Blackbat-AI/ArmBoard_Hardware/README.md

# ArmBoardHardware
Hardware design files for robotic arm

Master branch holds completed versions, branch arm board holds works in progress

Requires KiCAD libraries 5.1.7 and MRDT_KiCAD_Libraries 2021 Release 1
