Blackbat-AI/ArmBoard_Hardware/Documentation/Notes/TivaPinOut.PNG

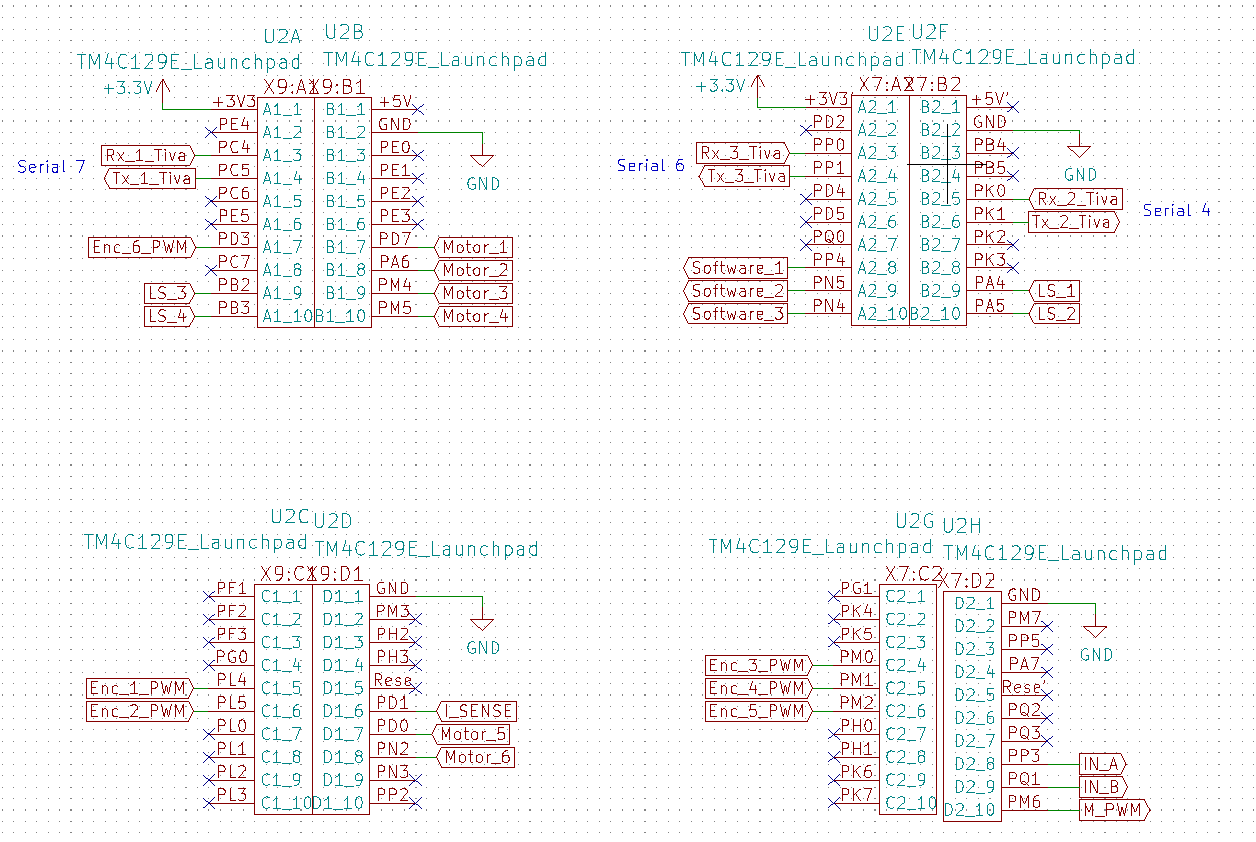
Documentation/Notes/TivaPinOut.PNG
