Blackbat-AI/ArmBoard_Hardware/Manufacturing/Armboard BOM.xlsx

Id | Designator | Package | Designation | Item Name | Part Number | Vendor | Quantity | Cost Per Item | Cost | URL | Comments | Quantity
 | U2 | TM4C129E_Launchpad_FULL_SMD_BOTTOM | TM4C129E_Launchpad | LAUNCHPAD TM4C129E EVAL BRD | 296-44249-ND | Digikey | 1 | $29.99 | $29.99 | EK-TM4C129EXL Texas Instruments | Development Boards, Kits, Programmers | DigiKey (https://www.digikey.com/en/products/detail/texas-instruments/EK-TM4C129EXL/5764631)
 | 47uF2,47uF1 | CP_Radial_D5.0mm_P2.50mm | CP2 | CAP ALUM 47UF 20% 16V RADIAL | 493-15997-ND | Digikey | 1 | $0.26 | $0.26 | USR1C470MDD Nichicon | Capacitors | DigiKey (https://www.digikey.com/en/products/detail/nichicon/USR1C470MDD/2539212)
 | U1 | OKI_Horizontal | OKI | DC DC CONVERTER 3.3V 5W | 811-3014-ND | Digikey | 1 | $4.30 | $4.30 | https://www.digikey.com/product-detail/en/murata-power-solutions-inc/OKI-78SR-3.3-1.5-W36H-C/811-3014-ND/4878851
 | C3,C2,10uF1,10uF2,10uF3,10uF4 | C_0603_1608Metric_Pad1.05x0.95mm_HandSolder | 10uF | CAP CER 10UF 10V X5R 0603 | 399-C0603C106M8PAC7411CT-ND | Digikey | 6 | $0.46 | $2.76 | C0603C106M8PAC7411 KEMET | Capacitors | DigiKey (https://www.digikey.com/en/products/detail/kemet/C0603C106M8PAC7411/12701345)
 | Conn20,Conn19,Conn18,Conn13,Conn12,Conn11,Conn10,Conn9,Conn8 | MOLEX_SL_03_Vertical | Molex_SL_03 | CONN HOUSING 3POS .100 W/LATCH | WM2901-ND | Digikey | 9 | set of 10 for $1.86 | $1.86 | https://www.digikey.com/products/en?keywords=WM2901-ND
 | Conn17,Conn16,Conn15,Conn14 | MOLEX_SL_02_Vertical | Molex_SL_02 | CONN HOUSING 2POS .100 W/LATCH | WM2900-ND | Digikey | 4 | $0.29 | $1.16 | https://www.digikey.com/products/en?keywords=WM2900-ND
 | SW6,SW5,SW4,SW3,SW2,SW1 | SW_Push_1P1T_NO_6x6mm_H9.5mm | SW_Push | SWITCH TACTILE SPST-NO 0.05A 24V | 450-2058-1-ND | Digikey | 6 | $0.37 | $2.22 | FSM6JSMATR TE Connectivity ALCOSWITCH Switches | Switches | DigiKey (https://www.digikey.com/en/products/detail/te-connectivity-alcoswitch-switches/FSM6JSMATR/2400236)
 | R39,R38,R37,R36,R35,R34,R33,R32,R31,R30,R29,R28,R27,R26,R25,R24,R23,R22,R21,R20,R19,R18,R17,R16,R15,R10 | R_0603_1608Metric_Pad1.05x0.95mm_HandSolder | 330 | RES SMD 330 OHM 5% 1/4W 0603 | RHM330DCT-ND | Digikey | 26 | 3 sets of 10 for $0.74 each | $2.22 | ESR03EZPJ331 Rohm Semiconductor | Resistors | DigiKey (https://www.digikey.com/en/products/detail/rohm-semiconductor/ESR03EZPJ331/1762730)
 | R14,R13,R12,R11,R9 | R_0603_1608Metric_Pad1.05x0.95mm_HandSolder | 1.2k | RES SMD 1.2K OHM 5% 1/4W 0603 | RHM1.2KDCT-ND | Digikey | 5 | $0.10 | $0.50 | ESR03EZPJ122 Rohm Semiconductor | Resistors | DigiKey (https://www.digikey.com/en/products/detail/rohm-semiconductor/ESR03EZPJ122/4051189)
 | R8,R7,R6,R4,R2,R1 | R_0603_1608Metric_Pad1.05x0.95mm_HandSolder | 1k | RES SMD 1K OHM 5% 1/4W 0603 | RHM1.0KDCT-ND | Digikey | 6 | $0.10 | $0.60 | https://www.digikey.com/product-detail/en/rohm-semiconductor/ESR03EZPJ102/RHM1.0KDCT-ND/1762924
 | R5 | R_0603_1608Metric_Pad1.05x0.95mm_HandSolder | 10k | RES SMD 10K OHM 1% 1/4W 0603 | RHM10KADCT-ND | Digikey | 1 | $0.12 | $0.12 | https://www.digikey.com/product-detail/en/rohm-semiconductor/ESR03EZPF1002/RHM10KADCT-ND/1983753
 | R3 | R_0603_1608Metric_Pad1.05x0.95mm_HandSolder | 0 | RES SMD 0 OHM JUMPER 1/10W 0603 | 311-0.0GRCT-ND | Digikey | 1 | $0.10 | $0.10 | https://www.digikey.com/products/en?keywords=311-0.0GRCT-ND
 | Gripper_Motor1 | MultiPowerSO_30 | VNH5019A_E | IC MTR DRV 5.5-24V MULTIPWRSO-30 | 497-13073-1-ND | Digikey | 1 | $7.68 | $7.68 | VNH5019A-E STMicroelectronics | Integrated Circuits (ICs) | DigiKey (https://www.digikey.com/en/products/detail/stmicroelectronics/VNH5019A-E/3087979)
 | D6,D3,D4,D5,D2,D7 | LED_0603_1608Metric_Pad1.05x0.95mm_HandSolder | LED | LED GREEN CLEAR SMD | 160-1446-1-ND | Digikey | 6 | $0.26 | $1.56 | https://www.digikey.com/product-detail/en/lite-on-inc/LTST-C191KGKT/160-1446-1-ND/386834
 | D9,D10,D11,D12,D13,D14,D18,D19,D20,D21,D22,D23,D24,D25,D26,D27 | LED_0603_1608Metric_Pad1.05x0.95mm_HandSolder | LED | LED YELLOW CLEAR SMD | 160-1448-1-ND | Digikey | 16 | 2 sets of 10 for $1.51 each | $3.02 | https://www.digikey.com/product-detail/en/lite-on-inc/LTST-C191KSKT/160-1448-1-ND/386838
 | D15,D16,D17,D28,D29,D30,D31,D32,D33 | LED_0603_1608Metric_Pad1.05x0.95mm_HandSolder | LED | LED BLUE CLEAR CHIP SMD | 160-1647-1-ND | Digikey | 9 | set of 10 for $2.62 | $2.62 | https://www.digikey.com/product-detail/en/lite-on-inc/LTST-C191TBKT/160-1647-1-ND/573587
 | D1 | D_SOD-323_HandSoldering | D_Zener | DIODE ZENER 12V 200MW SOD323 | BZX384C12-HE3-08GICT-ND | Digikey | 1 | $0.25 | $0.25 | BZX384C12-HE3-08 Vishay Semiconductor Diodes Division | Discrete Semiconductor Products | DigiKey (https://www.digikey.com/en/products/detail/vishay-semiconductor-diodes-division/BZX384C12-HE3-08/4831089)
 | C1 | C_0603_1608Metric_Pad1.05x0.95mm_HandSolder | 33nF | CAP CER 0.033UF 16V X7R 0603 | 399-C0603C333K4RACAUTOCT-ND | Digikey | 1 | $0.12 | $0.12 | C0603C333K4RACAUTO KEMET | Capacitors | DigiKey (https://www.digikey.com/en/products/detail/kemet/C0603C333K4RACAUTO/11675839)
 | .1uF1 | C_0603_1608Metric_Pad1.05x0.95mm_HandSolder | C1 | CAP CER 0.1UF 16V X7R 0603 | 1276-1005-1-ND | Digikey | 1 | $0.10 | $0.10 | https://www.digikey.com/product-detail/en/samsung-electro-mechanics/CL10B104KO8NNNC/1276-1005-1-ND/3889091
 | Conn1,Conn4,Conn3,Conn2,Conn6 | Anderson_2_Vertical_Sidy_by_Side,Anderson_3_Ho Anderson PP | AndersonPP | Black Anderson Housing | 1327G6 | Powerwerx | 4 | $0.37 | $1.48 | Anderson Power Products 1327 series PP15/30/45 Powerpole Connector Colored Housings | Powerwerx (https://powerwerx.com/anderson-powerpole-colored-housings)
 |  |  |  | Red Anderson Housing | 1327 | Powerwerx | 7 | $0.37 | $2.59 | Anderson Power Products 1327 series PP15/30/45 Powerpole Connector Colored Housings | Powerwerx (https://powerwerx.com/anderson-powerpole-colored-housings)
 |  |  |  | 15A Contact | 1332 | Powerwerx | 11 | $0.18 | $1.98 | 1332-BK Anderson Power PP15 Powerpole Connector Contact, 16-20 GA, 15A, Loose Piece | Powerwerx (https://powerwerx.com/anderson-1332-powerpole-contact-pp15)
 |  |  |  | Vertical Mount | 1335G1 | Powerwerx | 8 | $0.59 | $4.72 | Anderson Power 1335G1 Printed Circuit Board High Power 45 Amp Vertical Contact | Powerwerx (https://powerwerx.com/anderson-1335g1-printed-circuit-board-vertical)
 |  |  |  | Horizontal Mount | 1336G1 | Powerwerx | 3 | $0.55 | $1.65 | Anderson Power 1336G1 Printed Circuit Board High Power 45 Amp Horizontal Bottom Contact | Powerwerx (https://powerwerx.com/anderson-1336g1-printed-circuit-board-horizontal)
