Blackbat-AI/ArmBoard_Hardware/Hardware/Armboard/Armboard.kicad_pcb

## KiCad design Hardware/Armboard/Armboard.kicad_pcb (2020-11-26)

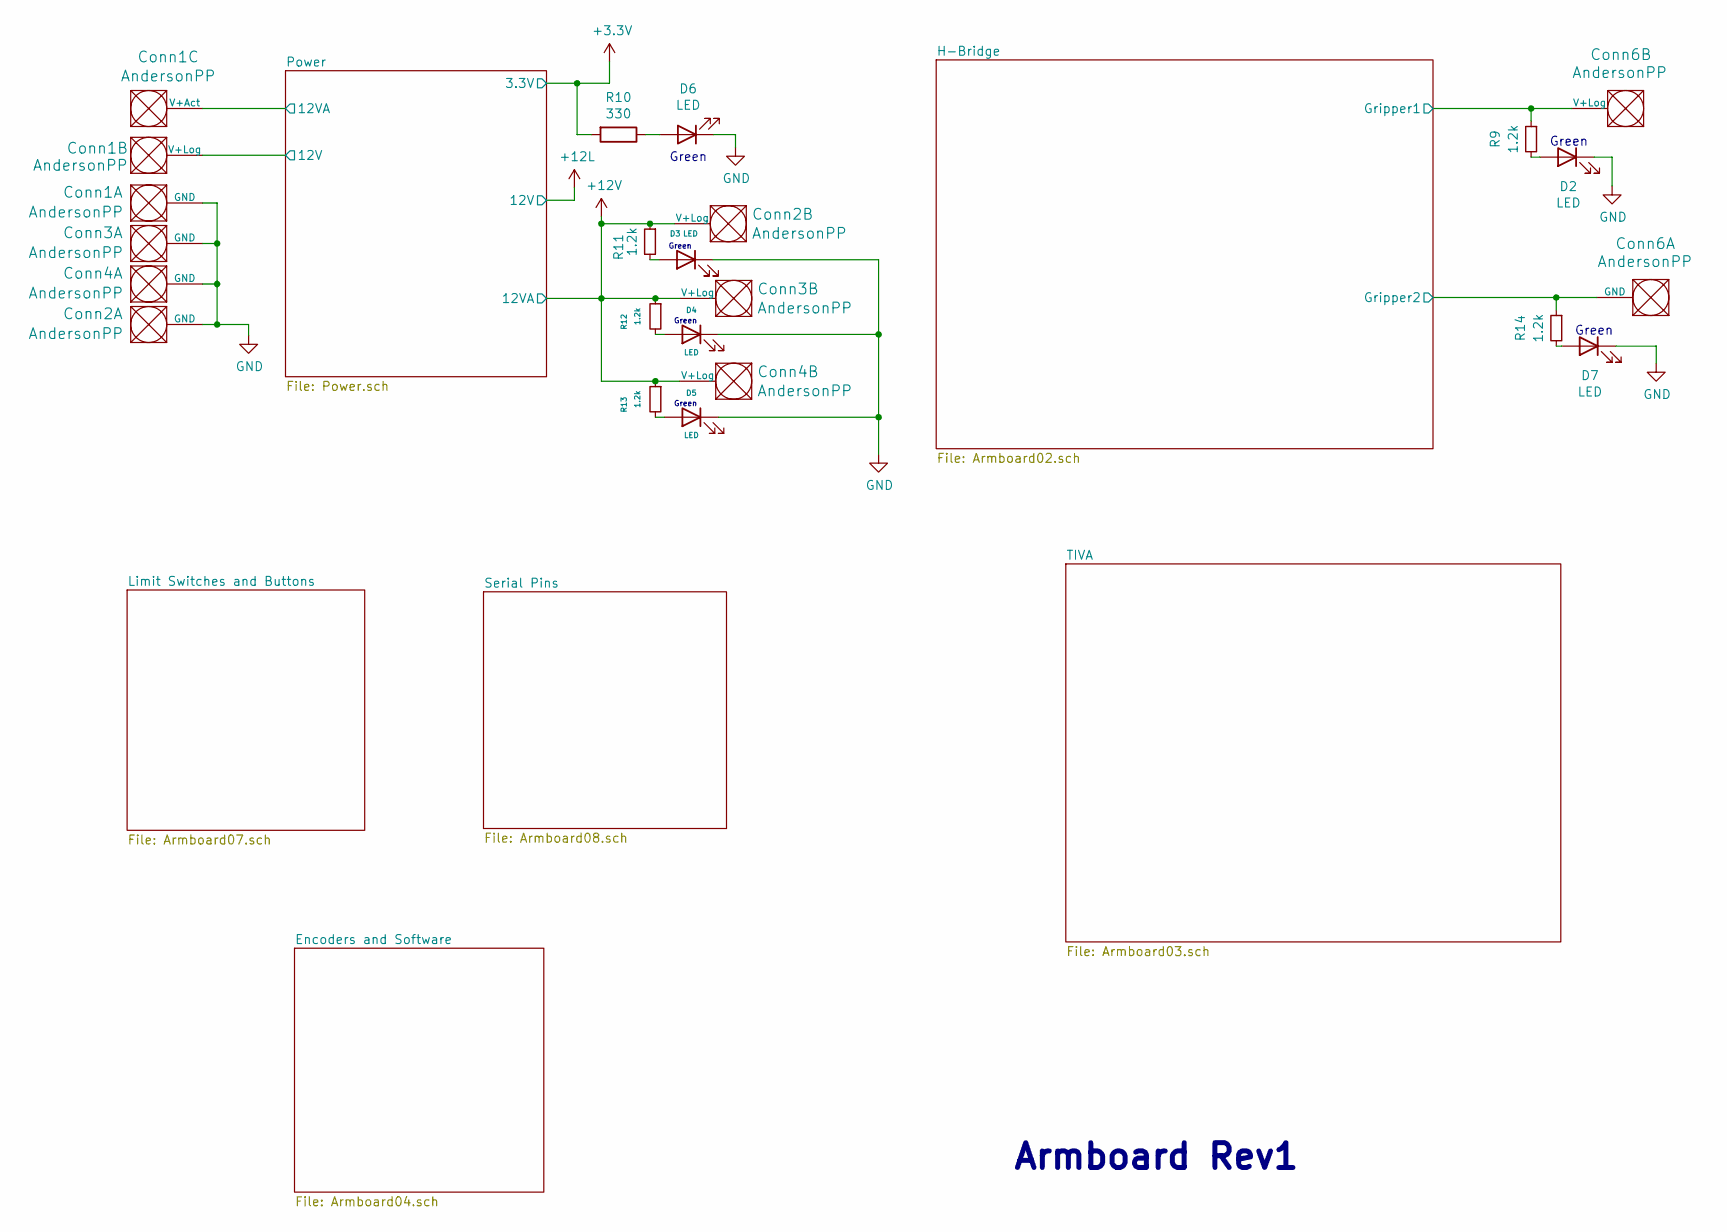
[picture p2: schematic Armboard.sch]

Parts:
Conn1: AndersonPP; Anderson_3_Horizontal_Side_by_Side
Conn2, Conn3, Conn4, Conn6: AndersonPP; Anderson_2_Vertical_Sidy_by_Side
D2, D3, D4, D5, D6, D7: LED; D_0603_1608Metric_Pad1.05x0.95mm_HandSolder
R9, R11, R12, R13, R14: 1.2k; R_0603_1608Metric_Pad0.98x0.95mm_HandSolder
R10: 330; R_0603_1608Metric_Pad0.98x0.95mm_HandSolder

Connections:
+3V3: R10.2; also elsewhere on the board
+12L: Conn1.2 (V+Log); also elsewhere on the board
+12V: Conn1.3 (V+Act), Conn2.2 (V+Log), Conn3.2 (V+Log), Conn4.2 (V+Log), R11.1, R12.1, R13.1; also elsewhere on the board
/H-Bridge/Gripper1: Conn6.2 (V+Log), R9.1; also elsewhere on the board
/H-Bridge/Gripper2: Conn6.1 (GND), R14.1; also elsewhere on the board
GND: Conn1.1 (GND), Conn2.1 (GND), Conn3.1 (GND), Conn4.1 (GND), D2.1 (K), D3.1 (K), D4.1 (K), D5.1 (K), D6.1 (K), D7.1 (K); also elsewhere on the board
unnamed: D2.2 (A), R9.2
unnamed: D3.2 (A), R11.2
unnamed: D4.2 (A), R12.2
unnamed: D5.2 (A), R13.2
unnamed: D6.2 (A), R10.1
unnamed: D7.2 (A), R14.2

Notes on the sheet:
Armboard Rev1
Green

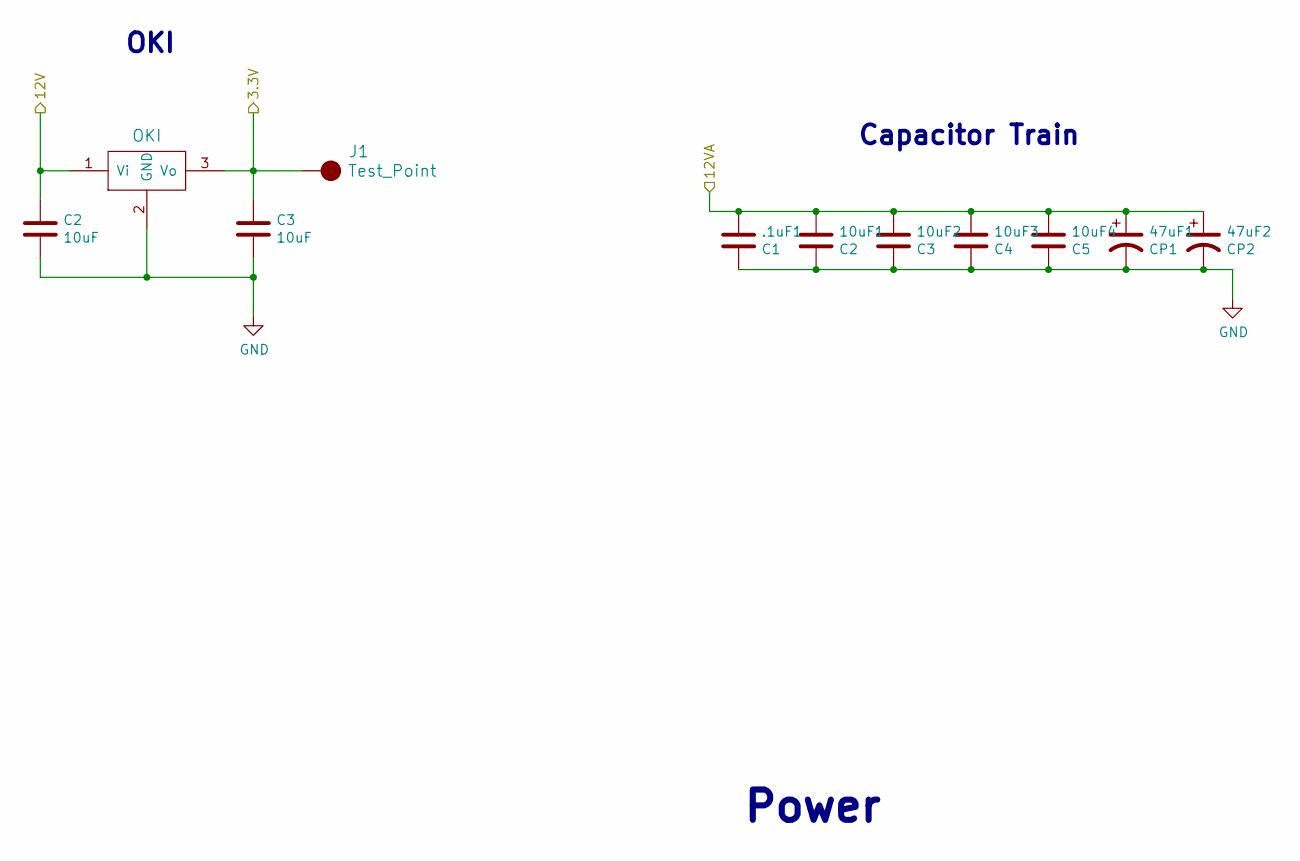
[picture p3: schematic Power.sch]

Parts:
10uF1: C2; C_0603_1608Metric_Pad1.08x0.95mm_HandSolder
10uF2: C3; C_0603_1608Metric_Pad1.08x0.95mm_HandSolder
10uF3: C4; C_0603_1608Metric_Pad1.08x0.95mm_HandSolder
10uF4: C5; C_0603_1608Metric_Pad1.08x0.95mm_HandSolder
47uF1: CP1; CP_Radial_D5.0mm_P2.50mm
47uF2: CP2; CP_Radial_D5.0mm_P2.50mm
.1uF1: C1; C_0603_1608Metric_Pad1.08x0.95mm_HandSolder
C2, C3: 10uF; C_0603_1608Metric_Pad1.08x0.95mm_HandSolder
J1: Test_Point; TestPoint_Pad_3.0x3.0mm
U1: OKI; OKI_Horizontal

Connections:
+3V3: C3.1, J1.1, U1.3 (Vo); also elsewhere on the board
+12L: C2.1, U1.1 (Vi); also elsewhere on the board
+12V: 10uF1.1, 10uF2.1, 10uF3.1, 10uF4.1, 47uF1.1, 47uF2.1, .1uF1.1; also elsewhere on the board
GND: 10uF1.2, 10uF2.2, 10uF3.2, 10uF4.2, 47uF1.2, 47uF2.2, .1uF1.2, C2.2, C3.2, U1.2 (GND); also elsewhere on the board

Notes on the sheet:
Capacitor Train
Power
OKI

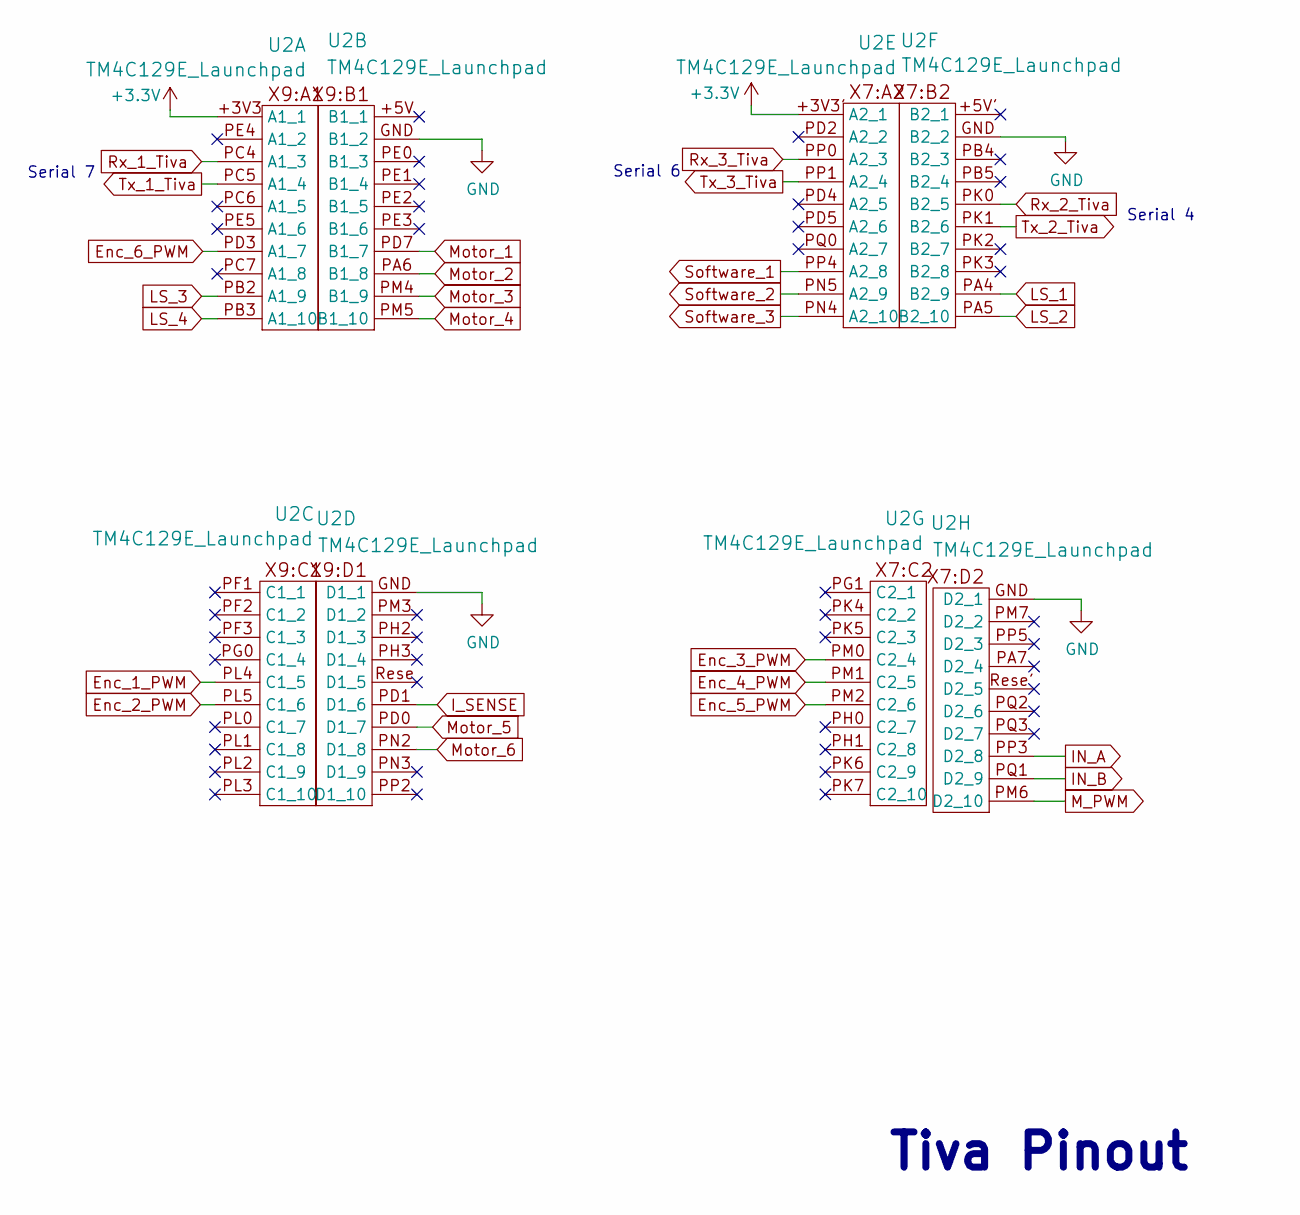
[picture p4: schematic Armboard03.sch]

Parts:
U2: TM4C129E_Launchpad; TM4C129E_Launchpad_FULL_SMD_BOTTOM

Connections:
+3V3: U2.+3V3 (A1_1), U2.+3V3' (A2_1); also elsewhere on the board
Enc_1_PWM: U2.PL4 (C1_5); also elsewhere on the board
Enc_2_PWM: U2.PL5 (C1_6); also elsewhere on the board
Enc_3_PWM: U2.PM0 (C2_4); also elsewhere on the board
Enc_4_PWM: U2.PM1 (C2_5); also elsewhere on the board
Enc_5_PWM: U2.PM2 (C2_6); also elsewhere on the board
Enc_6_PWM: U2.PD3 (A1_7); also elsewhere on the board
GND: U2.GND (B1_2); also elsewhere on the board
IN_A: U2.PP3 (D2_8); also elsewhere on the board
IN_B: U2.PQ1 (D2_9); also elsewhere on the board
I_SENSE: U2.PD1 (D1_6); also elsewhere on the board
LS_1: U2.PA4 (B2_9); also elsewhere on the board
LS_2: U2.PA5 (B2_10); also elsewhere on the board
LS_3: U2.PB2 (A1_9); also elsewhere on the board
LS_4: U2.PB3 (A1_10); also elsewhere on the board
M_PWM: U2.PM6 (D2_10); also elsewhere on the board
Motor_1: U2.PD7 (B1_7); also elsewhere on the board
Motor_2: U2.PA6 (B1_8); also elsewhere on the board
Motor_3: U2.PM4 (B1_9); also elsewhere on the board
Motor_4: U2.PM5 (B1_10); also elsewhere on the board
Motor_5: U2.PD0 (D1_7); also elsewhere on the board
Motor_6: U2.PN2 (D1_8); also elsewhere on the board
Rx_1_Tiva: U2.PC4 (A1_3); also elsewhere on the board
Rx_2_Tiva: U2.PK0 (B2_5); also elsewhere on the board
Rx_3_Tiva: U2.PP0 (A2_3); also elsewhere on the board
Software_1: U2.PP4 (A2_8); also elsewhere on the board
Software_2: U2.PN5 (A2_9); also elsewhere on the board
Software_3: U2.PN4 (A2_10); also elsewhere on the board
Tx_1_Tiva: U2.PC5 (A1_4); also elsewhere on the board
Tx_2_Tiva: U2.PK1 (B2_6); also elsewhere on the board
Tx_3_Tiva: U2.PP1 (A2_4); also elsewhere on the board

Notes on the sheet:
Tiva Pinout
Serial 6
Serial 7
Serial 4

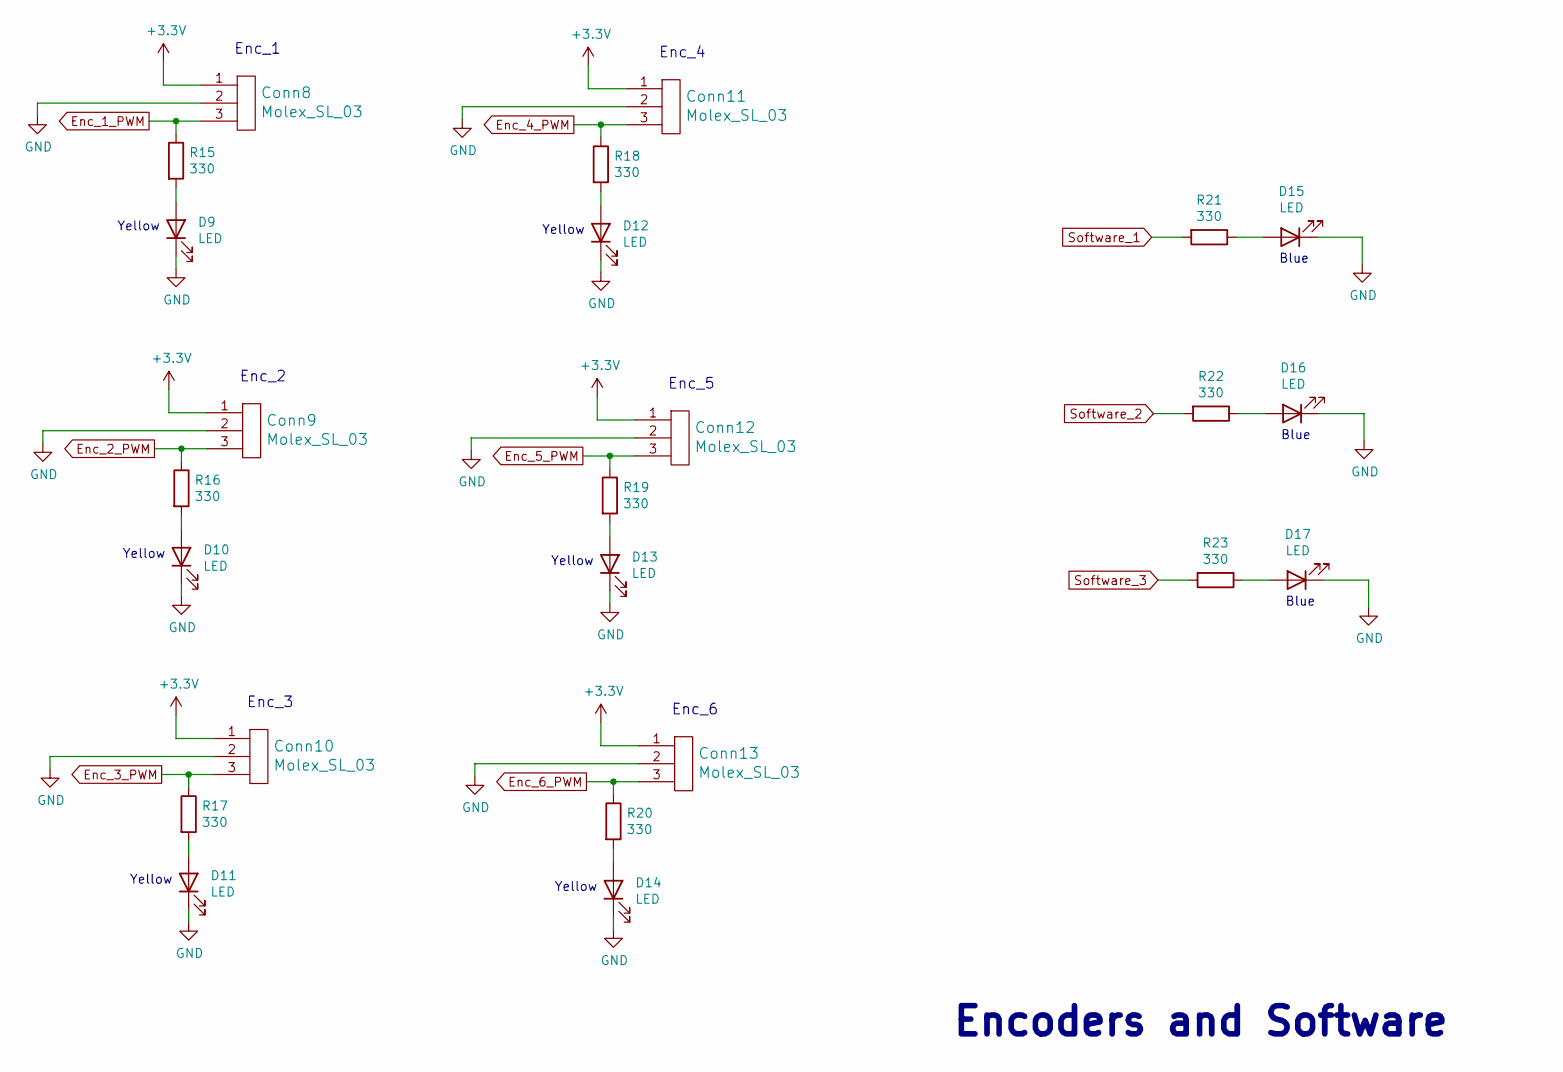
[picture p5: schematic Armboard04.sch]

Parts:
Conn8, Conn9, Conn10, Conn11, Conn12, Conn13: Molex_SL_03; MOLEX_SL_03_Vertical
D9, D10, D11, D12, D13, D14, D15, D16, D17: LED; D_0603_1608Metric_Pad1.05x0.95mm_HandSolder
R15, R16, R17, R18, R19, R20, R21, R22, R23: 330; R_0603_1608Metric_Pad0.98x0.95mm_HandSolder

Connections:
+3V3: Conn8.1, Conn9.1, Conn10.1, Conn11.1, Conn12.1, Conn13.1; also elsewhere on the board
Enc_1_PWM: Conn8.3, R15.1; also elsewhere on the board
Enc_2_PWM: Conn9.3, R16.1; also elsewhere on the board
Enc_3_PWM: Conn10.3, R17.1; also elsewhere on the board
Enc_4_PWM: Conn11.3, R18.1; also elsewhere on the board
Enc_5_PWM: Conn12.3, R19.1; also elsewhere on the board
Enc_6_PWM: Conn13.3, R20.1; also elsewhere on the board
GND: Conn8.2, Conn9.2, Conn10.2, Conn11.2, Conn12.2, Conn13.2, D9.1 (K), D10.1 (K), D11.1 (K), D12.1 (K), D13.1 (K), D14.1 (K), D15.1 (K), D16.1 (K), D17.1 (K); also elsewhere on the board
unnamed: D9.2 (A), R15.2
unnamed: D10.2 (A), R16.2
unnamed: D11.2 (A), R17.2
unnamed: D12.2 (A), R18.2
unnamed: D13.2 (A), R19.2
unnamed: D14.2 (A), R20.2
unnamed: D15.2 (A), R21.1
unnamed: D16.2 (A), R22.1
unnamed: D17.2 (A), R23.1
Software_1: R21.2; also elsewhere on the board
Software_2: R22.2; also elsewhere on the board
Software_3: R23.2; also elsewhere on the board

Notes on the sheet:
Enc_2
Enc_3
Enc_4
Enc_5
Enc_6
Encoders and Software
Enc_1
Yellow
Blue

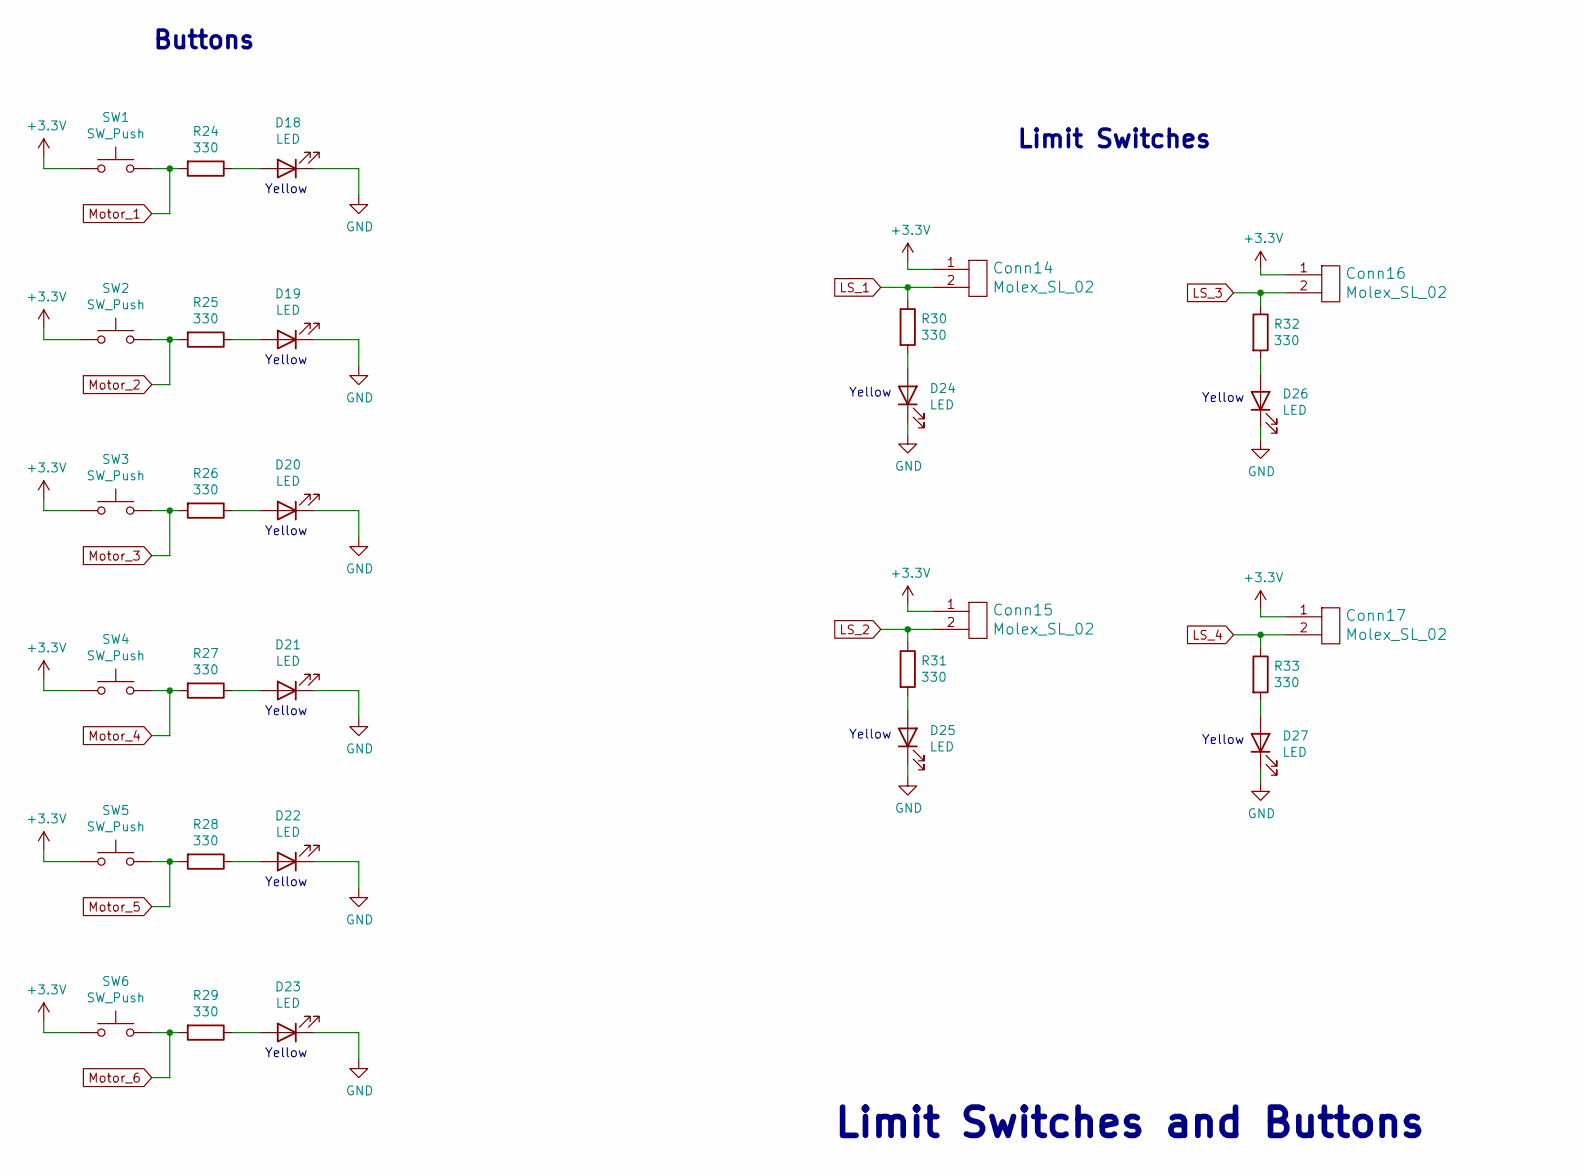
[picture p6: schematic Armboard07.sch]

Parts:
Conn14, Conn15, Conn16, Conn17: Molex_SL_02; MOLEX_SL_02_Vertical
D18, D19, D20, D21, D22, D23, D24, D25, D26, D27: LED; D_0603_1608Metric_Pad1.05x0.95mm_HandSolder
R24, R25, R26, R27, R28, R29, R30, R31, R32, R33: 330; R_0603_1608Metric_Pad0.98x0.95mm_HandSolder
SW1, SW2, SW3, SW4, SW5, SW6: SW_Push; SW_Push_1P1T_NO_6x6mm_H9.5mm

Connections:
+3V3: Conn14.1, Conn15.1, Conn16.1, Conn17.1, SW1.1, SW2.1, SW3.1, SW4.1, SW5.1, SW6.1; also elsewhere on the board
GND: D18.1 (K), D19.1 (K), D20.1 (K), D21.1 (K), D22.1 (K), D23.1 (K), D24.1 (K), D25.1 (K), D26.1 (K), D27.1 (K); also elsewhere on the board
LS_1: Conn14.2, R30.1; also elsewhere on the board
LS_2: Conn15.2, R31.1; also elsewhere on the board
LS_3: Conn16.2, R32.1; also elsewhere on the board
LS_4: Conn17.2, R33.1; also elsewhere on the board
Motor_1: R24.2, SW1.2; also elsewhere on the board
Motor_2: R25.2, SW2.2; also elsewhere on the board
Motor_3: R26.2, SW3.2; also elsewhere on the board
Motor_4: R27.2, SW4.2; also elsewhere on the board
Motor_5: R28.2, SW5.2; also elsewhere on the board
Motor_6: R29.2, SW6.2; also elsewhere on the board
unnamed: D18.2 (A), R24.1
unnamed: D19.2 (A), R25.1
unnamed: D20.2 (A), R26.1
unnamed: D21.2 (A), R27.1
unnamed: D22.2 (A), R28.1
unnamed: D23.2 (A), R29.1
unnamed: D24.2 (A), R30.2
unnamed: D25.2 (A), R31.2
unnamed: D26.2 (A), R32.2
unnamed: D27.2 (A), R33.2

Notes on the sheet:
Yellow
Limit Switches and Buttons
Limit Switches
Buttons

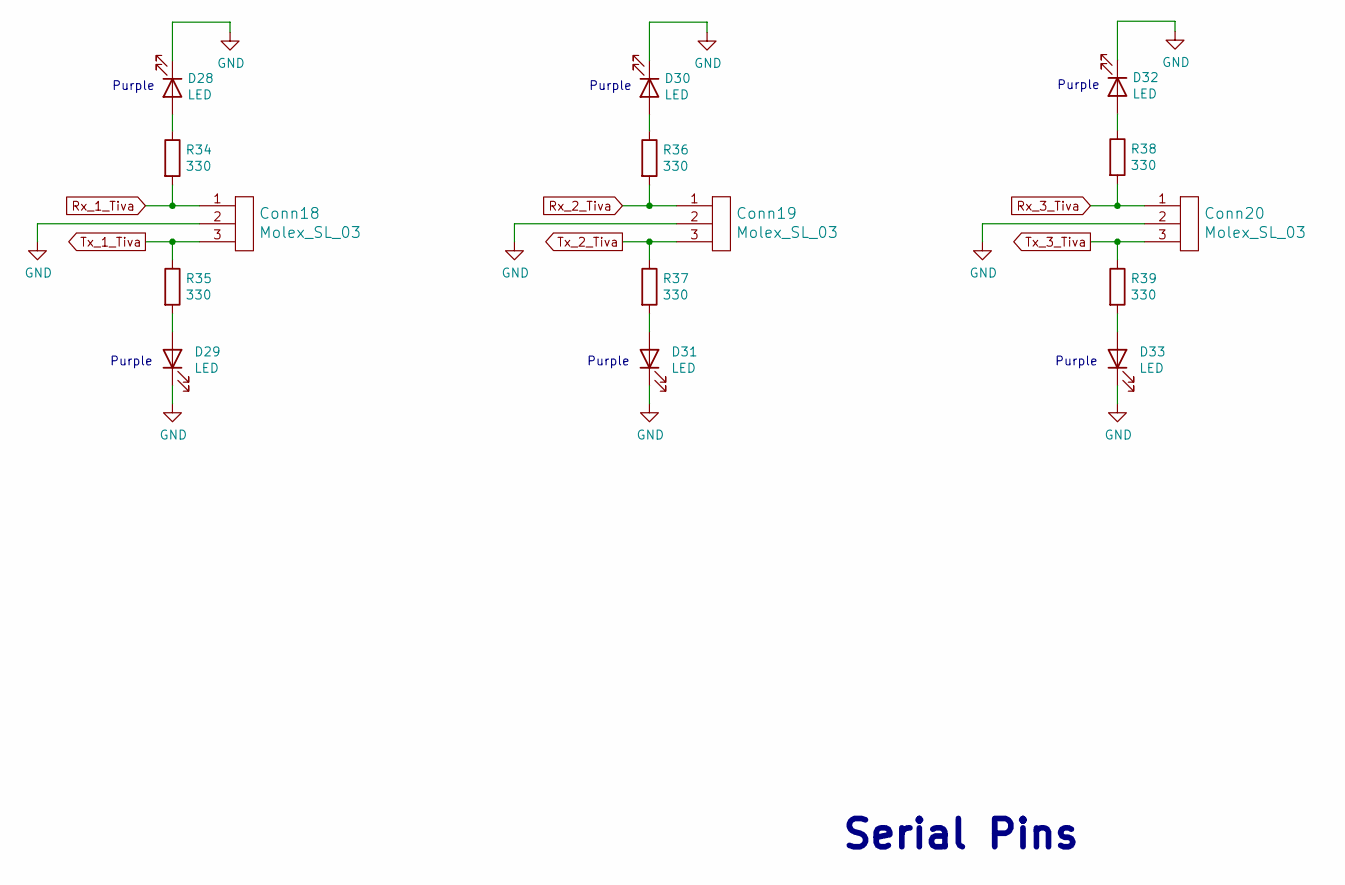
[picture p7: schematic Armboard08.sch]

Parts:
Conn18, Conn19, Conn20: Molex_SL_03; MOLEX_SL_03_Vertical
D28, D29, D30, D31, D32, D33: LED; D_0603_1608Metric_Pad1.05x0.95mm_HandSolder
R34, R35, R36, R37, R38, R39: 330; R_0603_1608Metric_Pad0.98x0.95mm_HandSolder

Connections:
GND: Conn18.2, Conn19.2, Conn20.2, D28.1 (K), D29.1 (K), D30.1 (K), D31.1 (K), D32.1 (K), D33.1 (K); also elsewhere on the board
unnamed: D28.2 (A), R34.1
unnamed: D29.2 (A), R35.2
unnamed: D30.2 (A), R36.1
unnamed: D31.2 (A), R37.2
unnamed: D32.2 (A), R38.1
unnamed: D33.2 (A), R39.2
Rx_1_Tiva: Conn18.1, R34.2; also elsewhere on the board
Rx_2_Tiva: Conn19.1, R36.2; also elsewhere on the board
Rx_3_Tiva: Conn20.1, R38.2; also elsewhere on the board
Tx_1_Tiva: Conn18.3, R35.1; also elsewhere on the board
Tx_2_Tiva: Conn19.3, R37.1; also elsewhere on the board
Tx_3_Tiva: Conn20.3, R39.1; also elsewhere on the board

Notes on the sheet:
Serial Pins
Purple

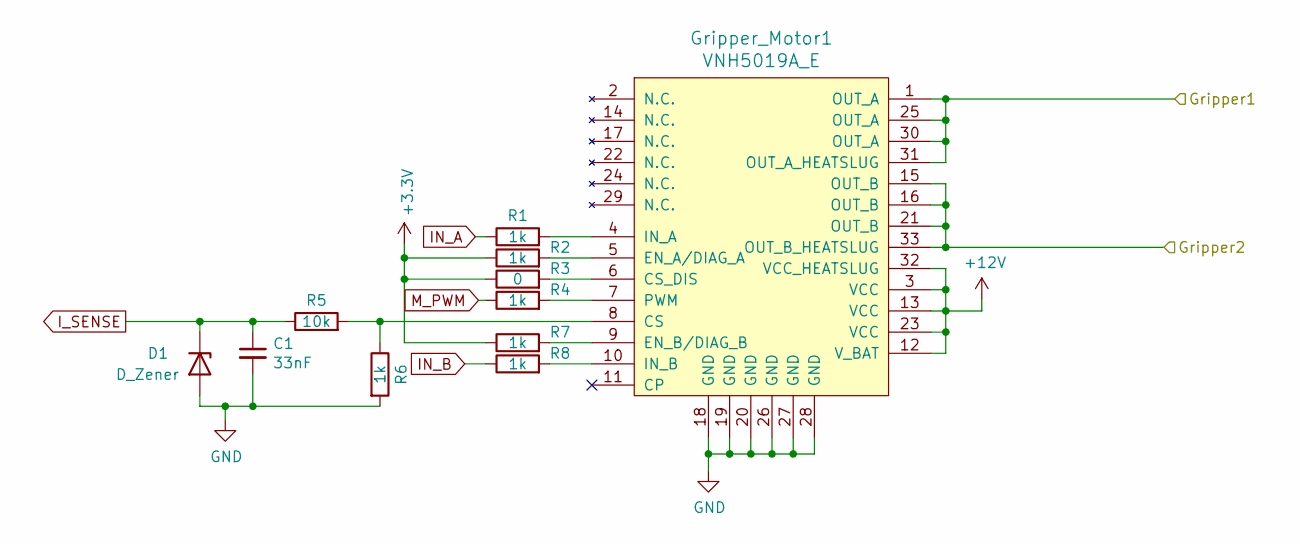
[picture p8: schematic Armboard02.sch]

Parts:
C1: 33nF; C_0603_1608Metric_Pad1.08x0.95mm_HandSolder
D1: D_Zener; D_SOD-323_HandSoldering
Gripper_Motor1: VNH5019A_E; MultiPowerSO_30
R1, R2, R4, R6, R7, R8: 1k; R_0603_1608Metric_Pad0.98x0.95mm_HandSolder
R3: 0; R_0603_1608Metric_Pad0.98x0.95mm_HandSolder
R5: 10k; R_0603_1608Metric_Pad0.98x0.95mm_HandSolder

Connections:
+3V3: R2.1, R3.1, R7.1; also elsewhere on the board
+12V: Gripper_Motor1.3 (VCC), Gripper_Motor1.12 (V_BAT), Gripper_Motor1.13 (VCC), Gripper_Motor1.23 (VCC), Gripper_Motor1.32 (VCC_HEATSLUG); also elsewhere on the board
/H-Bridge/Gripper1: Gripper_Motor1.1 (OUT_A), Gripper_Motor1.25 (OUT_A), Gripper_Motor1.30 (OUT_A), Gripper_Motor1.31 (OUT_A_HEATSLUG); also elsewhere on the board
/H-Bridge/Gripper2: Gripper_Motor1.15 (OUT_B), Gripper_Motor1.16 (OUT_B), Gripper_Motor1.21 (OUT_B), Gripper_Motor1.33 (OUT_B_HEATSLUG); also elsewhere on the board
GND: C1.2, D1.2 (A), Gripper_Motor1.18 (GND), Gripper_Motor1.19 (GND), Gripper_Motor1.20 (GND), Gripper_Motor1.26 (GND), Gripper_Motor1.27 (GND), Gripper_Motor1.28 (GND), R6.2; also elsewhere on the board
IN_A: R1.1; also elsewhere on the board
IN_B: R8.1; also elsewhere on the board
I_SENSE: C1.1, D1.1 (K), R5.1; also elsewhere on the board
M_PWM: R4.1; also elsewhere on the board
unnamed: Gripper_Motor1.4 (IN_A), R1.2
unnamed: Gripper_Motor1.5 (EN_A/DIAG_A), R2.2
unnamed: Gripper_Motor1.6 (CS_DIS), R3.2
unnamed: Gripper_Motor1.7 (PWM), R4.2
unnamed: Gripper_Motor1.8 (CS), R5.2, R6.1
unnamed: Gripper_Motor1.9 (EN_B/DIAG_B), R7.2
unnamed: Gripper_Motor1.10 (IN_B), R8.2

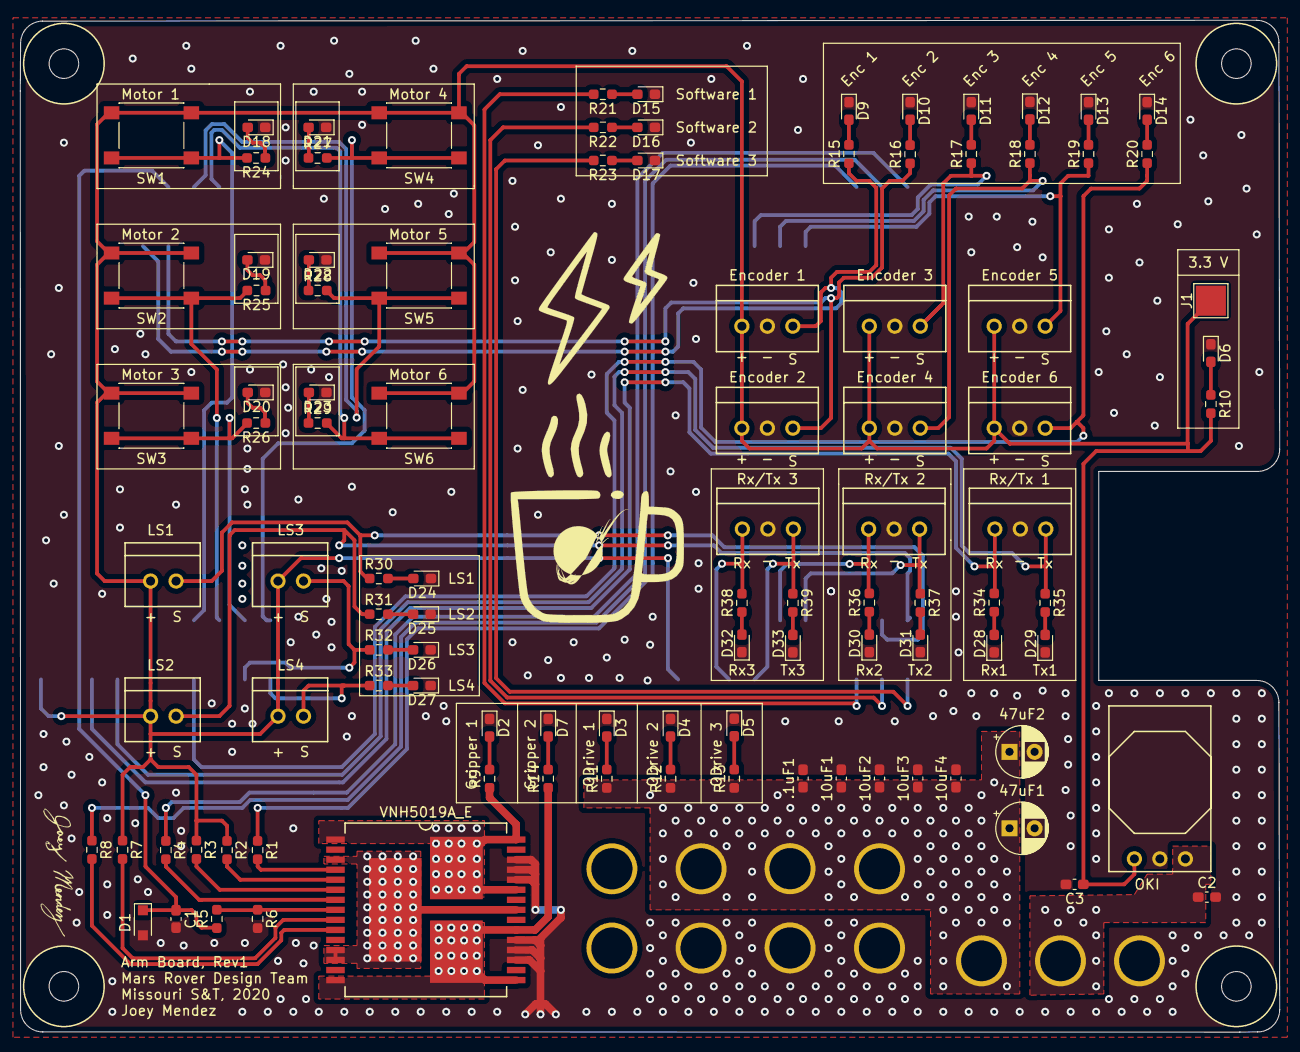
[picture p9: board Armboard.kicad_pcb from above]

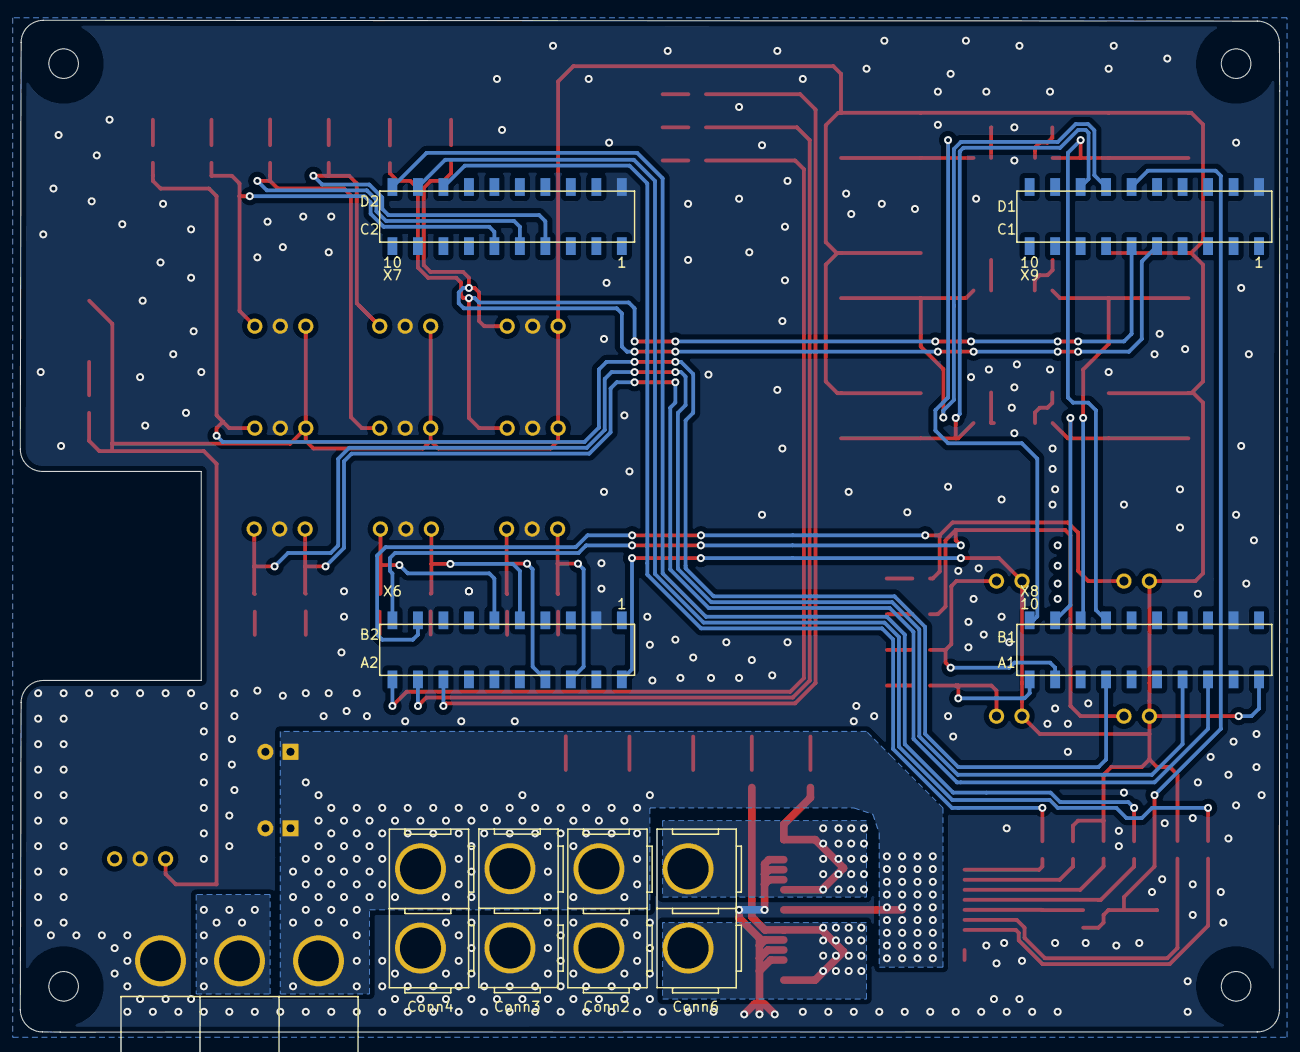
[picture p10: board Armboard.kicad_pcb from below]

Board: 2 copper layers, 125.5 x 100.8 mm, 109 parts (5 on the bottom side), 73 nets.
