Blackbat-AI/ArmBoard_Hardware/(commit log)

2020-09-11 Created Project
    [ArmBoard_Hardware-B_Cu.gbr, ArmBoard_Hardware-B_Mask.gbr, ArmBoard_Hardware-B_Paste.gbr, ArmBoard_Hardware-B_SilkS.gbr, ArmBoard_Hardware-Edge_Cuts.gbr, ArmBoard_Hardware-F_Cu.gbr, ArmBoard_Hardware-F_Mask.gbr, ArmBoard_Hardware-F_Paste.gbr]
2020-09-11 Created proper page size and one hierarchal sheet for indicators
    [Armboard1.sch]
2020-09-20 Added Capacitor Train to Power Heirarchal sheet
    [Armboard.sch, Power.sch]
2020-09-20 Added Anderson connectors to power section
    [Power.sch]
2020-09-20 Power Board Schematic Update
    [Power.sch]
2020-09-20 Added OKI to power
    [Power.sch]
2020-09-29 Put Anderson connectors on front page, replaced OKI with Buckman converter
    [Armboard.sch, Armboard1.sch, Power.sch]
2020-09-29 Added empty heirarchical sheets
    [Armboard.sch, Armboard01.sch, Armboard02.sch, Armboard03.sch, Armboard04.sch, Armboard05.sch, Armboard06.sch, Armboard07.sch]
2020-09-30 Added nothing
    [Armboard.sch, Armboard02.sch, Armboard03.sch, Armboard04.sch, Armboard05.sch, Armboard06.sch, Armboard07.sch, Armboard08.sch]
2020-09-30 Added TIVA Device and changed page sizes
    [Armboard02.sch, Armboard03.sch, Armboard04.sch, Armboard05.sch, Armboard06.sch, Armboard07.sch, Armboard08.sch, Power.sch]
2020-10-03 Added, Solenoid actuation, laser control, and encoders
    [Armboard04.sch, Armboard05.sch, Armboard06.sch]
2020-10-08 H-Bridge completed
    Completed the H-Bridge Hierarchal Sheet
    [Armboard.sch, Armboard02.sch, Armboard03.sch, Armboard04.sch, Armboard05.sch, Armboard06.sch, Power.sch]
2020-10-12 Added serial pins, limit switches, titles, and indicators
    [Armboard.sch, Armboard03.sch, Armboard04.sch, Armboard05.sch, Armboard06.sch, Armboard07.sch, Armboard08.sch, Power.sch]
2020-10-12 Tiva Updates
    [Armboard03.sch, Armboard05.sch, Armboard06.sch, Armboard07.sch]
2020-10-12 Formatted GNDs and added motor toggle buttons
    [Armboard.sch, Armboard03.sch, Armboard04.sch, Armboard07.sch, Armboard08.sch]
2020-10-12 Updated H-Bridge
    Made the appropriate changes suggested by anthony in slack chat regarding the H-Bridge's flaws
    [Armboard.sch, Armboard02.sch]
2020-10-13 Moved I/O outside of Power block
    [Armboard.sch, Armboard07.sch, Power.sch]
2020-10-20 Zener fix
    Replaced the schotkey diode or however you spell it, with the zener diode
    [Armboard02.sch]
2020-10-22 Fixed buttons/switches page, changed resistor values, fixed some tiva connections
    [Armboard.sch, Armboard03.sch, Armboard04.sch, Armboard07.sch, Armboard08.sch]
2020-10-25 Added TIVA pins to H-Bridge
    Added the missing TIVA pins to the H-Bridge
    [Armboard03.sch]
2020-10-25 Review 2 board changes
    -Connected the busses on the power and H-Bridge
    -Changed the resistor value to 1.2k
    -Fixed some of the pin locations on the TIVA
    -Added ferrites to the H-Bridge
    -Connected the buses so that they all highlight correctly
    [Armboard.sch, Armboard02.sch, Armboard03.sch, Armboard04.sch, Armboard05.sch, Armboard06.sch, Armboard07.sch, Armboard08.sch]
2020-10-29 Fixed changes from review 2 of circuit board
    except the LED indicators
    [Armboard.sch, Armboard03.sch, Armboard05.sch]
2020-10-29 Added Software LEDs
    [Armboard.sch, Armboard03.sch, Armboard04.sch]
2020-10-29 Fixed software flags
    [Armboard03.sch, Armboard04.sch]
2020-11-10 Deleted laser and solenoid
    [Armboard.sch, Armboard02.sch, Armboard03.sch, Armboard04.sch, Armboard07.sch, Armboard08.sch, Power.sch]
2020-11-10 Attempted to add 12 VL line
    [Armboard.sch, Armboard02.sch, Armboard07.sch, Power.sch]
2020-11-10 Assigned R/L/C footprints
    [Armboard.sch, Armboard02.sch, Armboard03.sch, Armboard04.sch, Armboard07.sch, Armboard08.sch, Power.sch]
2020-11-13 Added more footprints
    [Armboard.sch, Armboard02.sch, Armboard04.sch, Armboard07.sch, Armboard08.sch, Power.sch]
2020-11-13 Imported footprints to layout
    [Armboard.kicad_pcb, Armboard02.sch, Armboard03.sch, Armboard04.sch, Armboard07.sch, Armboard08.sch]
2020-11-13 Fixed Andersons, made netlist, imported footprints to layout
    [Armboard.kicad_pcb, Armboard.sch, Power.sch]
2020-11-13 Set board dimensions and started layout
    [Armboard.kicad_pcb]
2020-11-14 Added buckman and power leds to layout
    [Armboard.kicad_pcb]
2020-11-14 Added more components to layout
    [Armboard.kicad_pcb]
2020-11-15 Finished general component layout
    [Armboard.kicad_pcb, Power.sch]
2020-11-16 Made more connections to tiva
    [Armboard.kicad_pcb]
2020-11-16 Added more tiva connections. Moved LS connectors away from tiva pins. Started moving ENC connectors away from tiva pins.
    [Armboard.kicad_pcb]
2020-11-16 Finished tiva connections
    [Armboard.kicad_pcb]
2020-11-16 Added ground planes
    [Armboard.kicad_pcb]
2020-11-20 Double-checked schematic, pointed power pins up, made sure 12V and 3.3V were full networks
    [Armboard.sch, Armboard02.sch, Armboard03.sch, Armboard07.sch, Power.sch]
2020-11-20 Replaced buckman with OKI
    [Power.sch]
2020-11-20 Updated footprints, generated new netlist
    [Power.sch]
2020-11-20 Started updating layout. Connected edge cuts
    [Armboard.kicad_pcb]
2020-11-20 Routed 12VL and 12VA zones. Done?
    [Armboard.kicad_pcb]
2020-11-20 Rounded edge cuts, added silkscreen header
    [Armboard.kicad_pcb]
2020-11-20 Added silkscreen designs
    [Armboard.kicad_pcb, Power.sch]
2020-11-21 Added more labels, fixed 12VA/12L connections, filled gnd islands, +/-/S labels, added drillhole footprints
    [Armboard.kicad_pcb, Armboard.sch]
2020-11-21 less vias
    [Armboard.kicad_pcb]
2020-11-21 moved some labels around, added rx/tx pin labels
    [Armboard.kicad_pcb]
2020-11-24 Created BOM
    [Armboard.csv, BOM Template.xlsx]
2020-11-24 Updated BOM
    [BOM Template.xlsx]
2020-11-24 Completed BOM
    [BOM Template.xlsx]
2020-11-24 Completed Gerbs
    [Armboard-B_Cu.gbr, Armboard-B_Mask.gbr, Armboard-B_Paste.gbr, Armboard-B_SilkS.gbr, Armboard-Edge_Cuts.gbr, Armboard-F_Cu.gbr, Armboard-F_Mask.gbr, Armboard-F_Paste.gbr]
2020-11-24 Deleted BOM template file
    [Armboard BOM.xlsx, Armboard.csv]
2020-11-26 Fixed some library issues and moved Gerbs to Manufacturing folder
    [ArmBoardBom.xlsx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]
